willianjsf/Patinhas-CFA/Relatorios/imagens/coleira_produto.png

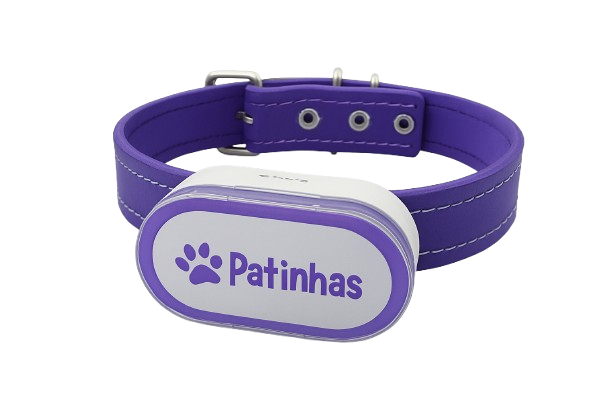
Relatorios/imagens/coleira_produto.png
