willianjsf/Patinhas-CFA/Relatorios/imagens/conexao_esp32c3.png

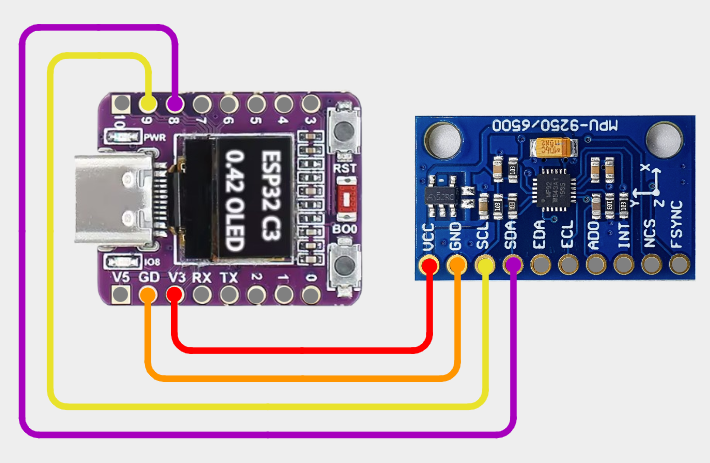
Relatorios/imagens/conexao_esp32c3.png
