willianjsf/Patinhas-CFA/Relatorios/imagens/conexao_esp32devkit.png

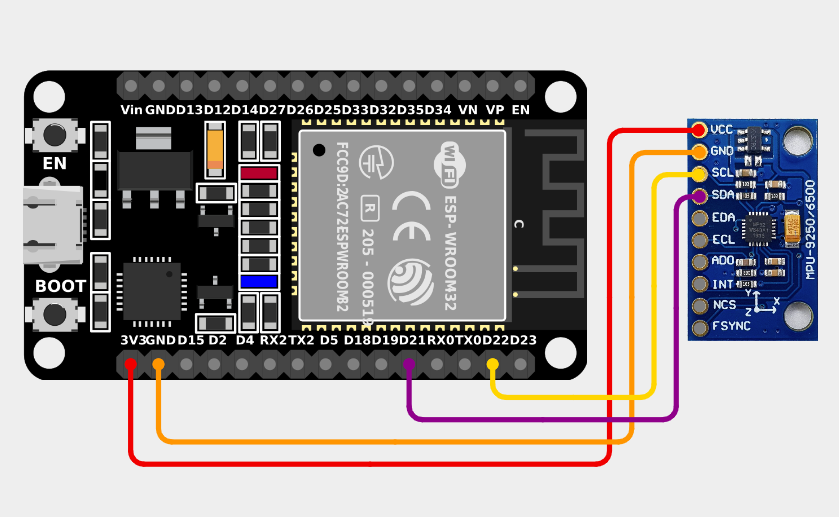
Relatorios/imagens/conexao_esp32devkit.png
