willianjsf/Patinhas-CFA/Relatorios/imagens/esp32c3supermini.png

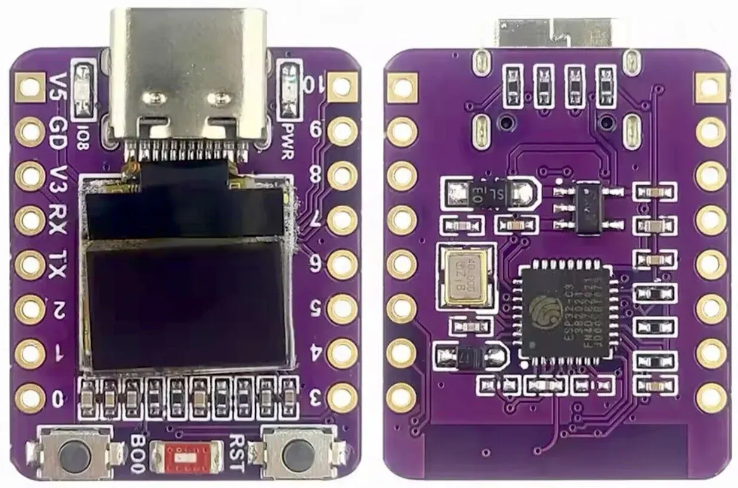
Relatorios/imagens/esp32c3supermini.png
