willianjsf/Patinhas-CFA/Relatorios/imagens/final.png

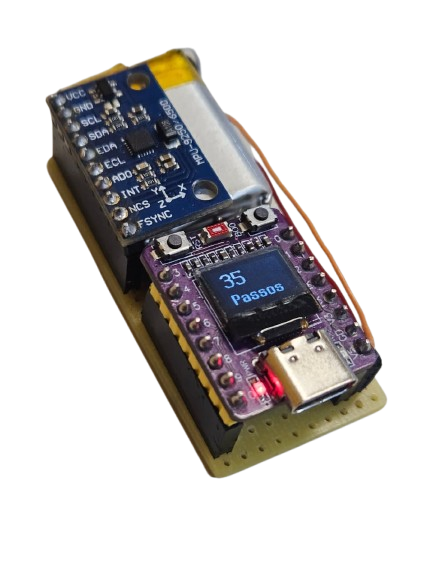
Relatorios/imagens/final.png
