willianjsf/Patinhas-CFA/Relatorios/imagens/lilypadpowersupply.jpg

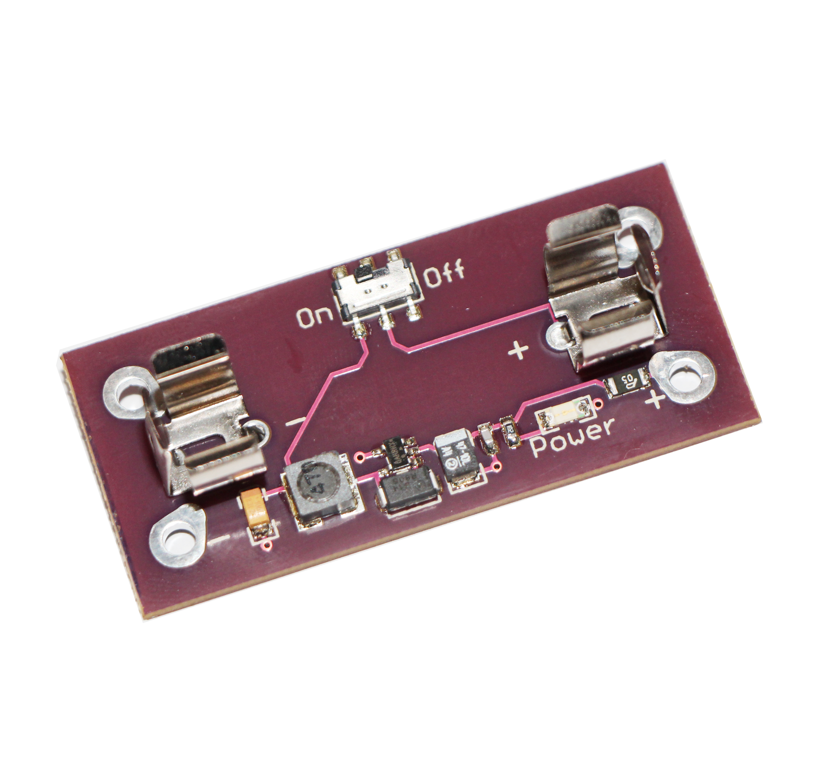
Relatorios/imagens/lilypadpowersupply.jpg
