willianjsf/Patinhas-CFA/Relatorios/imagens/lilypadpowersupply.png

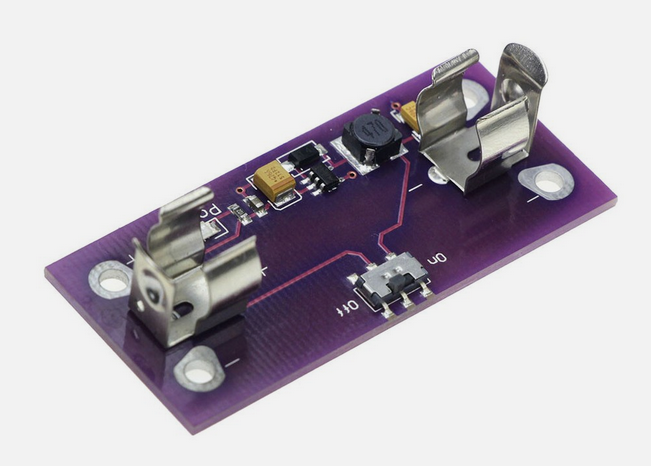
Relatorios/imagens/lilypadpowersupply.png
