willianjsf/Patinhas-CFA/Relatorios/imagens/mpu9250.png

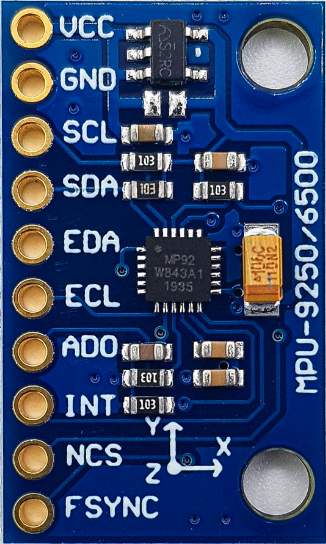
Relatorios/imagens/mpu9250.png
