willianjsf/Patinhas-CFA/Relatorios/imagens/patinhas0.png

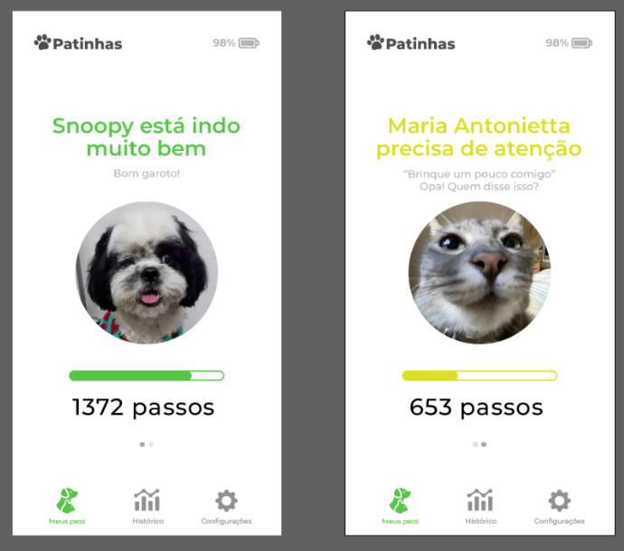
Relatorios/imagens/patinhas0.png
