willianjsf/Patinhas-CFA/Relatorios/imagens/pronto.png

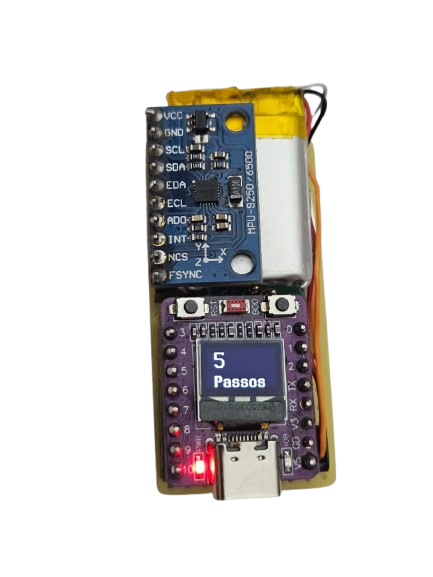
Relatorios/imagens/pronto.png
