willianjsf/Patinhas-CFA/(commit log)

2025-09-15 imagens/patinhas0.png
    Imagem ilustrativa da ideia inicial do app para o projeto.
2025-09-25 Create links.md
    Adicionando arquivo para por links dos diarios
2025-10-01 adicionado algoritmo inicial de captação de passos
2025-10-01 correcao algoritmo de captação de passos
2025-10-30 Adicionei código Arduino movimento do cachorro
2025-11-23 Update relatorio.md by removing placeholder text
    Removed placeholder text and outlined materials and methods.
2025-11-24 Update components and assembly instructions in relatorio.md
    Revised the components list and added detailed assembly instructions for the toy dog interior.
2025-11-27 Reorganizei a pasta de relatórios
2025-11-27 Incluí a pasta Aplicacao que contém o código do ESP32, o backend e o frontend
2025-11-27 Deletei a pasta src. Ela possuia a versão do código que roda no ESP32-C3 com display, que já salvei numa outra branch
2025-11-27 Implement Arduino code for dog movement control
2025-11-29 Removi pastas de cache
